reubenlouw19-alt/Mini-UTM/Electronics/Circuit Layout.pdf

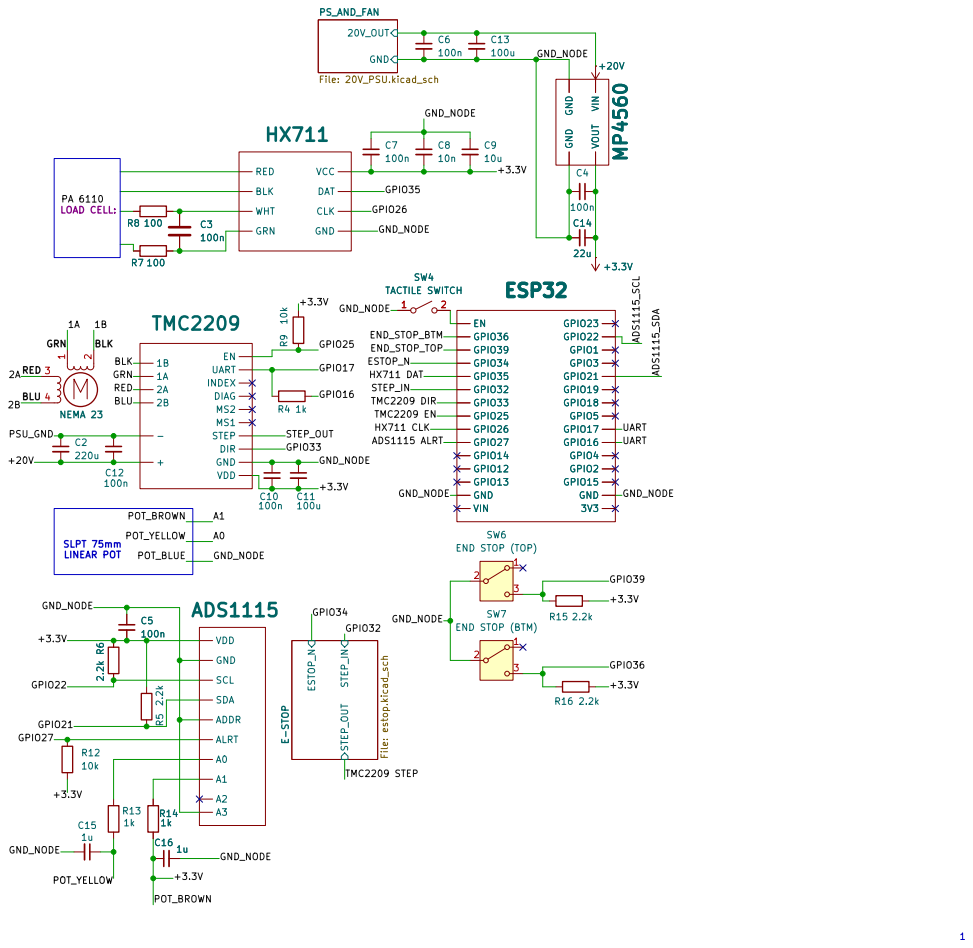
[picture p1: page 1]

ESTOP_N STEP_IN STEP_OUT E-STOP File: estop.kicad_sch 20V_OUT GND

END STOP (BTM) VDD
