reubenlouw19-alt/Mini-UTM/Electronics/E-STOP.pdf

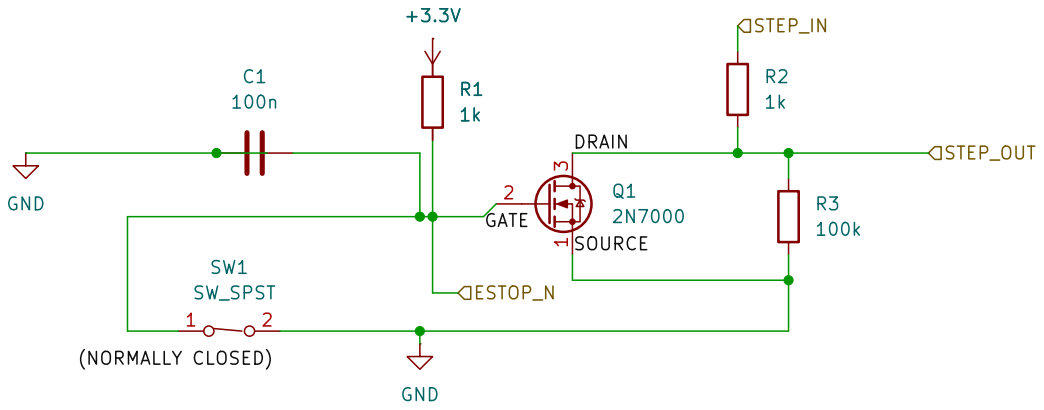
[picture p2: page 1]

Size: A4 | Rev:
KiCad E.D.A. 10.0.5 | Id: 2/5
