reubenlouw19-alt/Mini-UTM/Electronics/PS_AND_FAN.pdf

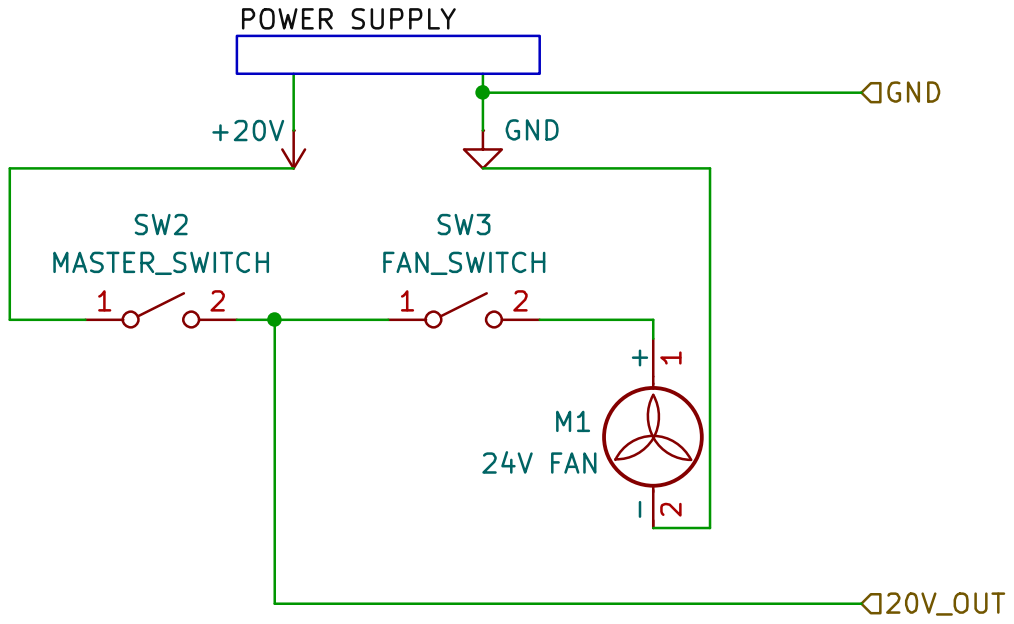
[picture p3: page 1]
