reubenlouw19-alt/Mini-UTM/Electronics/20V_PSU.kicad_sch

## KiCad design Electronics/20V_PSU.kicad_sch (2026-10-13)

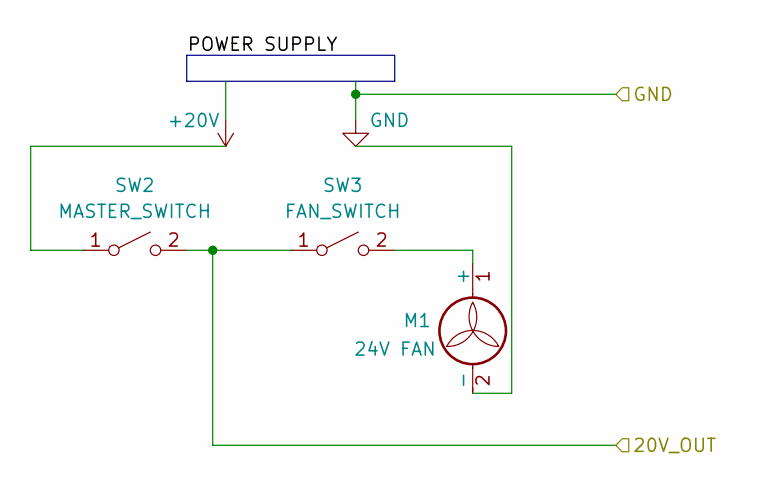
[picture p4: schematic 20V_PSU.kicad_sch]

Parts:
M1: 24V FAN
SW2: MASTER_SWITCH
SW3: FAN_SWITCH

Connections:
20V_OUT: SW2.2 (B), SW3.1 (A)
unnamed: M1.1 (+), SW3.2 (B)
