reubenlouw19-alt/Mini-UTM/Electronics/Circuit Layout.kicad_sch

## KiCad design Electronics/Circuit Layout.kicad_sch (2026-10-13)

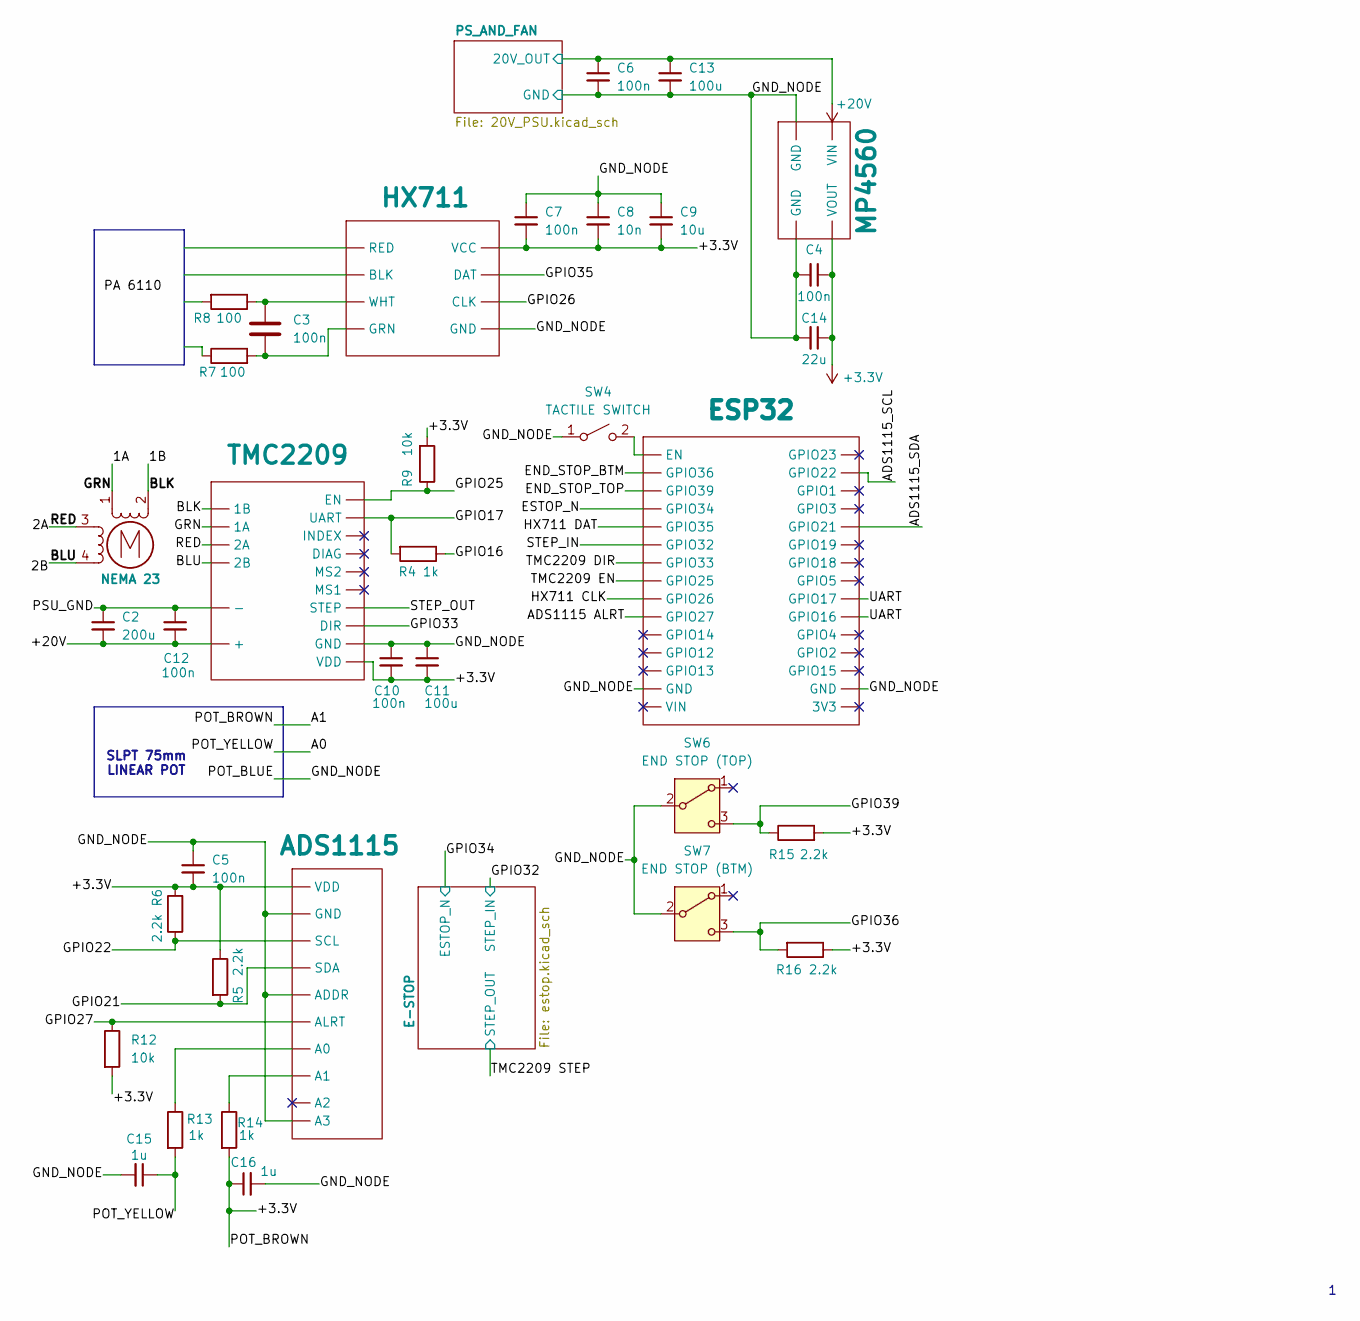
[picture p5: schematic Circuit Layout.kicad_sch]

Parts:
ADS1115: (no value)
C2: 200u
C3, C4, C5, C6, C7, C10, C12: 100n
C8: 10n
C9: 10u
C11, C13: 100u
C14: 22u
C15, C16: 1u
ESP32: (no value)
HX711: (no value)
M2: NEMA 23
MP4560: (no value)
R4, R13, R14: 1k
R5, R6, R15, R16: 2.2k
R7, R8: 100
R9, R12: 10k
SW4: TACTILE SWITCH
SW6: END STOP (TOP)
SW7: END STOP (BTM)
TMC2209: (no value)

Connections:
1A: M2.1, TMC2209.
1B: M2.2 (-), TMC2209.
2A: M2.3, TMC2209.
2B: M2.4, TMC2209.
+3.3V: ADS1115., C4.1, C5.2, C7.2, C8.2, C9.2, C10.2, C11.2, C14.1, C16.1, HX711., MP4560., R5.1, R6.2, R9.2, R12.2, R14.2, R15.2, R16.1, TMC2209.
+20V: C2.2, C6.1, C12.2, C13.1, TMC2209.
A0: C15.1, R13.2
ADS1115 ALRT: ESP32.
ADS1115_SCL: ESP32.
ADS1115_SDA: ESP32.
END_STOP_BTM: ESP32.
END_STOP_TOP: ESP32.
ESTOP_N: ESP32.
GND_NODE: ADS1115., C4.2, C5.1, C6.2, C7.1, C8.1, C9.1, C10.1, C11.1, C13.2, C14.2, C15.2, C16.2, ESP32., HX711., MP4560., SW4.1 (A), SW6.2 (B), SW7.2 (B), TMC2209.
GPIO16: R4.1
GPIO17: R4.2, TMC2209.
GPIO21: ADS1115., R5.2
GPIO22: ADS1115., R6.1
GPIO25: R9.1, TMC2209.
GPIO26: HX711.
GPIO27: ADS1115., R12.1
GPIO33: TMC2209.
GPIO35: HX711.
GPIO36: R16.2, SW7.3 (C)
GPIO39: R15.1, SW6.3 (C)
HX711 CLK: ESP32.
HX711 DAT: ESP32.
unnamed: ADS1115., R13.1, R14.1
unnamed: C3.1, HX711., R8.1
unnamed: C3.2, HX711., R7.2
unnamed: ESP32., SW4.2 (B)
PSU_GND: C2.1, C12.1, TMC2209.
STEP_IN: ESP32.
STEP_OUT: TMC2209.
TMC2209 DIR: ESP32.
TMC2209 EN: ESP32.
UART: ESP32.

Notes on the sheet:
SLPT 75mm LINEAR POT
