reubenlouw19-alt/Mini-UTM/Electronics/estop.kicad_sch

## KiCad design Electronics/estop.kicad_sch (2026-10-13)

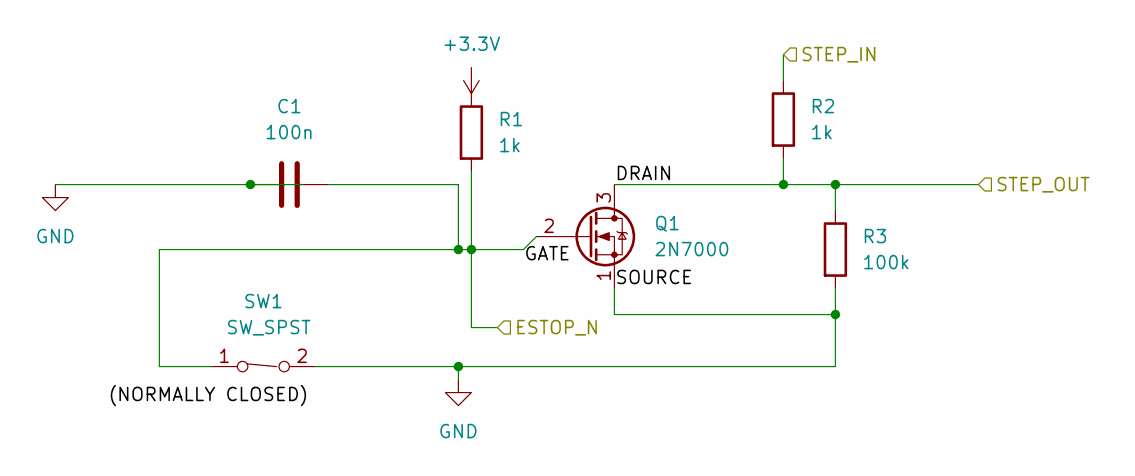
[picture p6: schematic estop.kicad_sch]

Parts:
C1: 100n
Q1: 2N7000; TO-92_Inline
R1, R2: 1k
R3: 100k
SW1: SW_SPST

Connections:
DRAIN: Q1.3 (D), R2.2, R3.1
ESTOP_N: C1.1, Q1.2 (G), R1.2, SW1.1 (A)
GND: C1.2, Q1.1 (S), R3.2, SW1.2 (B)
STEP_IN: R2.1
